GavinnnTann/EcoRig/EcoRig Schematic Rev C.pdf

## Li-Ion Battery

Ext.

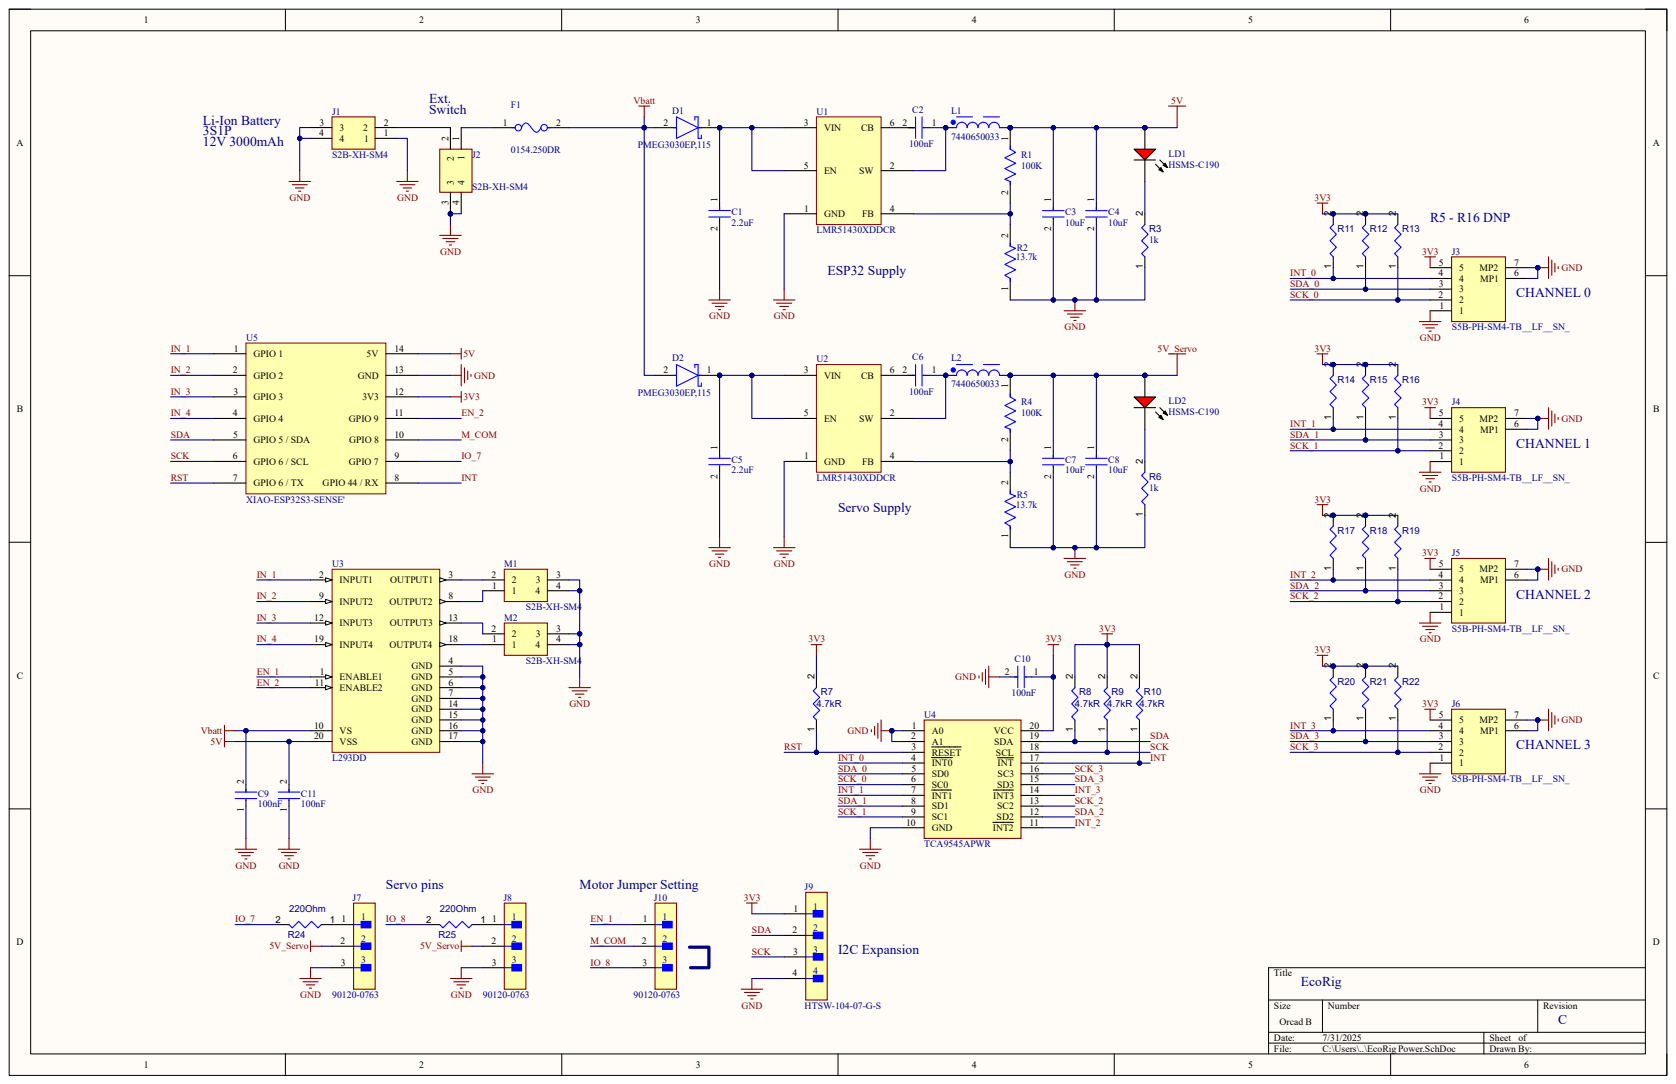
[picture p22: page 1]

Size Orcad B | Number | Revision C

Date: 7/31/2025 | Sheet of
File: C:\Users\..\EcoRig Power.SchDoc | Drawn By:
